NILM-automation/PCB_ESP32_SSR/README.md

# PCB_ESP32_SSR
PCB for the connection between the ESP32-WROOM-32 and a Solid State Relay. The ESP send an activation signal to SSR.

In adition, there is a temperature sensor texas tmp275
