NILM-automation/PCB_ESP32_SSR/Lista_elementos_PCB.xlsx

Sheet: LISTA ELEMENTOS
LISTA ELEMENTOS PCB NILM-UIS |  |  |  | LISTA ELEMENTOS PEDIDO DIGIKEY
CANTIDAD | DESCRIPCIÓN | PACKAGE | STOCK | CANTIDAD | DESCRIPCIÓN | PACKAGE | PRECIO
1 | LM1117 - 3,3 V | SOT-223 | SI | 2 | CAPACITOR 100 uF | X-0805 | $1.52
1 | CAPACITOR 100 uF | X-0805 | NO | 4 | PULSADOR | SMD | $2.80
1 | ESP32S | 32-S | SI | 10 | RESISTENCIA 10K | X-0805 | $0.48
4 | CAPACITOR 0,1 uF | X-0805 | SI | 2 | LED GREEN | X-0805 | $0.52
1 | CAPACITOR 4,7 uF | X-0805 | SI | 2 | LED RED | X-0805 | $0.52
2 | PULSADOR | SMD | NO | 10 | RESISTENCIA 12K | X-0805 | $0.49
5 | RESISTENCIA 10K | X-0805 | NO | 10 | RESISTENCIA 4,7K | X-0805 | $0.40
2 | CAPACITOR 1 uF | X-0805 | SI | 2 | TPD2S017 | SOT-95 | $1.22
2 | TRANSISTOR NPN S8050 | SOT-23 | NO | 4 | SP0503 | SOT-143 | $3.20
2 | LED | X-0805 | NO | 2 | PUERTO MICRO USB B 2,0 | SMD | $0.86
2 | RESISTENCIA 12K | X-0805 | NO | 10 | JUMPERS CON SUJETADOR |  | $1.74
1 | CP2102 | GM-QFN28 | SI | 3 | INA157U/2K5 | 8-SOIC | $11.37
1 | RESISTENCIA 4,7K | X-0805 | NO | 2 | SENSOR TEMPERATURA TMP275AIDR | 8-SOIC | $6.70
1 | TPD2S017 | SOT-95 | NO | 10 | CAPACITOR 0.01UF | X-0805 | $0.78
1 | SP0503 | SOT-143 | NO | 10 | RESISTENCIA 5K | X-0805 | $1.29
1 | PUERTO MICRO USB B 2,0 | SMD | NO | 10 | TRANSISTOR NPN S8050 | SOT-23 | $1.68
50 | REGLETA DE PINES | INSERCION | NO | 2 | RESISTENCIA 1M | X-0805 | $0.72
2 | CAPACITOR 10 uF | X-0805 | SI |  |  | TOTAL | $36.29
1 | BORNER DE 2 PUESTOS | INSERCION | NO |  | ENVIO USA - CASILLERO |  | $8.99
5 | JUMPERS CON SUJETADOR |  | NO |  | TAXES |  | $3.70
1 | INA157U/2K5 | SOIC-8 | NO |  | ENVIO CASILLERO - COL |  | $16.00
1 | SENSOR TEMPERATURA TMP275AIDR | SOIC-8 | NO |  |  | GRAN TOTAL USD | $64.98
3 | RESISTECNIAS 5K | X-0805 | NO |  |  | GRAN TOTAL COP | $259920.00
2 | CAPACIOTR 0.01UF | X-0805 | NO | DÓLAR
1 | RESISTENCIA 1M | X-0805 | NO | $4000.00

Sheet: COTIZACION_DIGIKEY
COTIZACIÓN ELEMENTOS PROJECT NILM-UIS EN DIGIKEY
CANTIDAD | DESCRIPCIÓN | PACKAGE | PART NUMBER | P / UNIDAD | P / TOTAL | LINK
1 | ESP32-WROOM-32 | SMD | 1904-1010-1-ND | 3.8 | 3.8 | https://www.digikey.com/product-detail/en/espressif-systems/ESP32-WROOM-32/1904-1010-1-ND/8544305
1 | REG 3.3V - LM1117 | SOT-223 | LM1117MPX-3.3/NOPBCT-ND | 1.1 | 1.1 | https://www.digikey.com/product-detail/en/texas-instruments/LM1117MPX-3-3-NOPB/LM1117MPX-3-3-NOPBCT-ND/1010516
2 | SWITCH TACTILE B3U-1000P | SMD | SW1020CT-ND | 0.98 | 1.96 | https://www.digikey.com/product-detail/en/omron-electronics-inc-emc-div/B3U-1000P/SW1020CT-ND/1534357
1 | SENSOR TEMP - TMP275AIDR | 8 - SOIC | 296-39296-1-ND | 3.35 | 3.35 | https://www.digikey.com/product-detail/en/TMP275AIDR/296-39296-1-ND/5143286/?itemSeq=319271916
1 | INA821ID | 8 - SOIC | 296-53404-ND | 6.19 | 6.19 | https://www.digikey.com/product-detail/en/texas-instruments/INA821ID/296-53404-ND/9858339
1 | CP2102-GM | QFN - 28 | 336-5890-1-ND | 1.4 | 1.4 | https://www.digikey.com/product-detail/en/silicon-labs/CP2102N-A02-GQFN28R/336-5890-1-ND/9863483
1 | TPD2S017DBVR | SOT - 23 | 296-25216-1-ND | 0.61 | 0.61 | https://www.digikey.com/product-detail/en/TPD2S017DBVR/296-25216-1-ND/2172703/?itemSeq=317171693
2 | TRANS NPN - MMSS8050-L-TP | SOT - 23 | MMSS8050-L-TPMSCT-ND | 0.18 | 0.36 | https://www.digikey.com/product-detail/en/MMSS8050-L-TP/MMSS8050-L-TPMSCT-ND/2827203/?itemSeq=324663815
1 | MICRO USB B - 10118192-001LF | SMD | 609-4613-1-ND | 0.43 | 0.43 | https://www.digikey.com/product-detail/en/10118192-0001LF/609-4613-1-ND/2785378/?itemSeq=317169616
1 | LED GREEN | SMD - 0805 | 475-1410-1-ND | 0.26 | 0.26 | https://www.digikey.com/product-detail/en/LG+R971-KN-1/475-1410-1-ND/1802598/?itemSeq=317171616
1 | LED RED | SMD - 0805 | 475-1415-1-ND | 0.26 | 0.26 | https://www.digikey.com/product-detail/en/LH+R974-LP-1/475-1415-1-ND/1802604/?itemSeq=317171622
1 | CAPACITOR 100 UF | SMD - 0805 | 490-13982-1-ND | 0.76 | 0.76 | https://www.digikey.com/product-detail/en/GRM31CR60J107KE39L/490-13982-1-ND/6155812/?itemSeq=317169822
6 | CAPACITOR 0.1 UF | SMD - 0805 | 399-1171-1-ND | 0.19 | 1.14 | https://www.digikey.com/product-detail/en/kemet/C0805C104J5RACTU/399-1171-1-ND/411446
2 | CAPACITOR 0.01 UF | SMD - 0805 | 399-17616-1-ND | 0.11 | 0.22 | https://www.digikey.com/product-detail/en/C0805C103J5RAC7210/399-17616-1-ND/8572616/?itemSeq=325112023
2 | CAPACITOR 1 UF | SMD - 0805 | 311-3498-1-ND | 0.33 | 0.66 | https://www.digikey.com/product-detail/en/yageo/CC0805JKX7R9BB105/311-3498-1-ND/7164519
1 | CAPACITOR 4.7 UF | SMD - 0805 | 399-15708-1-ND | 0.61 | 0.61 | https://www.digikey.com/product-detail/en/kemet/C0805C475J8RACAUTO/399-15708-1-ND/7427588
2 | CAPACITOR 10 UF | SMD - 0805 | 399-15693-1-ND | 0.83 | 1.66 | https://www.digikey.com/product-detail/en/kemet/C0805C106J8RACAUTO/399-15693-1-ND/7427573
5 | RESISTENCIA 10K | SMD - 0805 | A129761CT-ND | 0.1 | 0.5 | https://www.digikey.com/product-detail/en/CRGCQ0805F10K/A129761CT-ND/8577593/?itemSeq=317170571
3 | RESISTENCIA 5K | SMD - 0805 | 541-4321-1-ND | 0.14 | 0.42 | https://www.digikey.com/product-detail/en/CRCW08055K00FKTA/541-4321-1-ND/8565934/?itemSeq=319272543
2 | RESISTENCIA 12K | SMD - 0805 | A126337CT-ND | 0.1 | 0.2 | https://www.digikey.com/product-detail/en/CRG0805F12K/A126337CT-ND/7603392/?itemSeq=317170622
1 | RESISTENCIA 1M | SMD - 0805 | P20936CT-ND | 0.36 | 0.36 | https://www.digikey.com/product-detail/en/ERJ-PB6B1004V/P20936CT-ND/6215191/?itemSeq=325112308
1 | RESISTENCIA 25K (24,7K) | SMD - 0805 | A121556CT-ND | 0.65 | 0.65 | https://www.digikey.com/product-detail/en/te-connectivity-passive-product/CPF0805B25KE1/A121556CT-ND/5246518
2 | BORNERAS 2 POSICIONES | THROUGH HOLE | 277-6405-ND | 0.49 | 0.98 | https://www.digikey.com/product-detail/en/phoenix-contact/1935776/277-6405-ND/2513905
1 | BORNERAS 3 POSICIONES | THROUGH HOLE | 277-6072-ND | 0.77 | 0.77 | https://www.digikey.com/product-detail/en/phoenix-contact/1935789/277-6072-ND/2513906
2 | PIN HEADER X2 POSICIONES | THROUGH HOLE | 732-5315-ND | 0.13 | 0.26 | https://www.digikey.com/product-detail/en/w%C3%BCrth-elektronik/61300211121/732-5315-ND/4846823
1 | JUMPER CONECTOR | BULK | S9337-ND | 0.1 | 0.1 | https://www.digikey.com/product-detail/en/sullins-connector-solutions/QPC02SXGN-RC/S9337-ND/2618262
4 | PIN HEADER X9 POSICIONES | THROUGH HOLE | 732-5322-ND | 0.41 | 1.64 | https://www.digikey.com/product-detail/en/w%C3%BCrth-elektronik/61300911121/732-5322-ND/4846843
1 | PIN HEADER X1 POSICIONES | THROUGH HOLE | 609-3466-ND | 0.11 | 0.11 | https://www.digikey.com/product-detail/en/amphenol-icc-fci/68000-401HLF/609-3466-ND/2023286
 |  |  |  | TOTAL | 30.76
 |  |  |  | ENVIO USA | 18
 |  | DIVISA DÓLAR |  | ENVIO USA-COL | 16
 |  | 3800 |  | TOTAL (USD) | 64.76
 |  |  |  | TOTAL (COP) | 246088
