NILM-automation/PCB_ESP32_SSR/Libraries_EAGLE/2020-04-28_17-01-08/STL/D8_TEX.stp

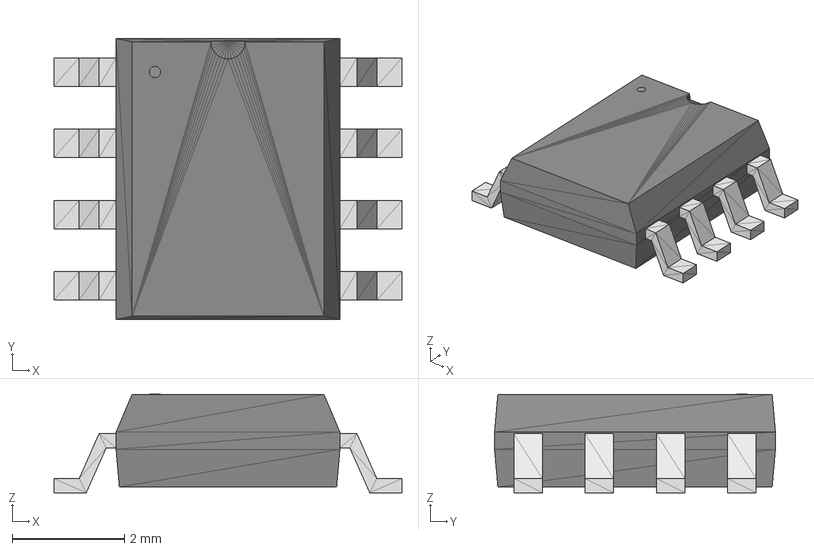
[picture p2: CAD file, 2020-05-02]
Libraries_EAGLE/2020-04-28_17-01-08/STL/D8_TEX.stp
6.20 x 5.00 x 1.75 mm
