NILM-automation/PCB_ESP32_SSR/Libraries_EAGLE/STEP/D0008A.stp

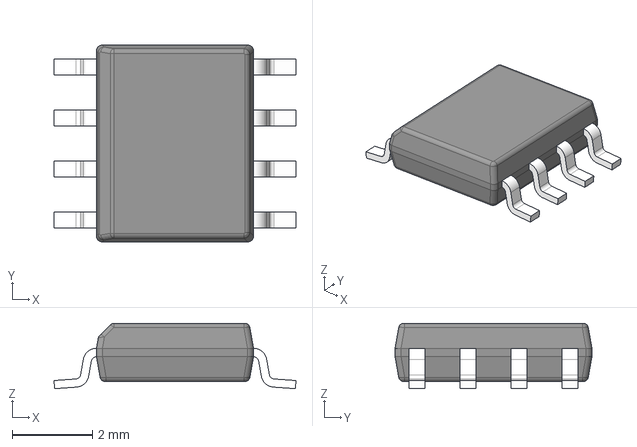
[picture p3: CAD file, 2020-05-11]
Libraries_EAGLE/STEP/D0008A.stp
6.02 x 4.90 x 1.63 mm
BODY-SO
LEAD-D0008A x 8
