NILM-automation/PCB_ESP32_SSR/(list of files, cad)

Other CAD files:
Libraries_EAGLE/2020-04-28_17-01-04/STEP/D8_TEX-L.step
Libraries_EAGLE/2020-04-28_17-01-08/STL/D8_TEX-L.stp
Libraries_EAGLE/2020-04-28_17-01-04/STEP/D8_TEX.step
Libraries_EAGLE/2020-04-28_17-01-08/STL/D8_TEX-M.stp
Libraries_EAGLE/2020-04-28_17-01-08/STL/D8_TEX-L.stl
Libraries_EAGLE/2020-04-28_17-01-08/STL/D8_TEX-M.stl
Libraries_EAGLE/2020-04-28_17-01-08/STL/D8_TEX.stl
