NILM-automation/PCB_ESP32_SSR/Simulaciones/NILM_PROJECT_TEST2-PSpiceFiles/SCHEMATIC1/test_2/test_2.cir

** Profile: "SCHEMATIC1-test_2"  [ e:\pcb_esp_usb\simulaciones\nilm_project_test2-pspicefiles\schematic1\test_2.sim ] 

** Creating circuit file "test_2.cir" 
** WARNING: THIS AUTOMATICALLY GENERATED FILE MAY BE OVERWRITTEN BY SUBSEQUENT SIMULATIONS

*Libraries: 
* Profile Libraries :
* Local Libraries :
.LIB "F:/Cadence/SPB_17.2/tools/pspice/library/INA821.lib" 
* From [PSPICE NETLIST] section of F:\SPB_Data\cdssetup\OrCAD_PSpice\17.2.0\PSpice.ini file:
.lib "nom.lib" 

*Analysis directives: 
.TRAN  0 3 0 0.001 
.OPTIONS ADVCONV
.PROBE64 V(alias(*)) I(alias(*)) W(alias(*)) D(alias(*)) NOISE(alias(*)) 
.INC "..\SCHEMATIC1.net" 


.END
