NILM-automation/PCB_ESP32_SSR/Libraries_Pspice/INA821_PSpice/INA821 Test Circuit-PSpiceFiles/SCHEMATIC1/INA821 Test Circuit/INA821 Test Circuit.cir

** Profile: "SCHEMATIC1-INA821 Test Circuit"  [ C:\Macromodels\Models\INA821\Release\RTM\INA821_PSpice\ina821 test circuit-pspicefiles\schematic1\ina821 test circuit.sim ] 

** Creating circuit file "INA821 Test Circuit.cir" 
** WARNING: THIS AUTOMATICALLY GENERATED FILE MAY BE OVERWRITTEN BY SUBSEQUENT SIMULATIONS

*Libraries: 
* Profile Libraries :
* Local Libraries :
.LIB "../../../ina821.lib" 
* From [PSPICE NETLIST] section of C:\Users\a0282827\AppData\Roaming\SPB_Data\cdssetup\OrCAD_PSpice/16.6.0/PSpice.ini file:
.lib "nom.lib" 

*Analysis directives: 
.TRAN  0 2m 0 2u 
.OPTIONS ADVCONV
.OPTIONS METHOD= Default
.AUTOCONVERGE ITL1=1000 ITL2=1000 ITL4=1000 RELTOL=0.05 ABSTOL=1.0E-6 VNTOL=.001 PIVTOL=1.0E-10 
.PROBE64 V(alias(*)) I(alias(*)) W(alias(*)) D(alias(*)) NOISE(alias(*)) 
.INC "..\SCHEMATIC1.net" 


.END
