NILM-automation/PCB_ESP32_SSR/(list of files, drawings)

Other design files:
Libraries_Pspice/INA157_PSPICE_AIO/INA157.DSN
Libraries_Pspice/INA157_PSPICE_AIO/INA157.OLB
Libraries_Pspice/INA157_PSPICE_AIO/INA157.opj
Libraries_Pspice/INA821_PSpice/INA821 TEST CIRCUIT.DSN
Libraries_Pspice/INA821_PSpice/INA821 Test Circuit.opj
Libraries_Pspice/INA821_PSpice/INA821.OLB
Simulaciones/NILM_PROJECT_TEST1.DSN
Simulaciones/NILM_PROJECT_TEST1.opj
Simulaciones/NILM_PROJECT_TEST2.DSN
Simulaciones/NILM_PROJECT_TEST2.opj
