NILM-automation/PCB_ESP32_SSR/Schematic_Board/esq_ordenado.brd

## EAGLE design Schematic_Board/esq_ordenado.brd (2020-06-04)

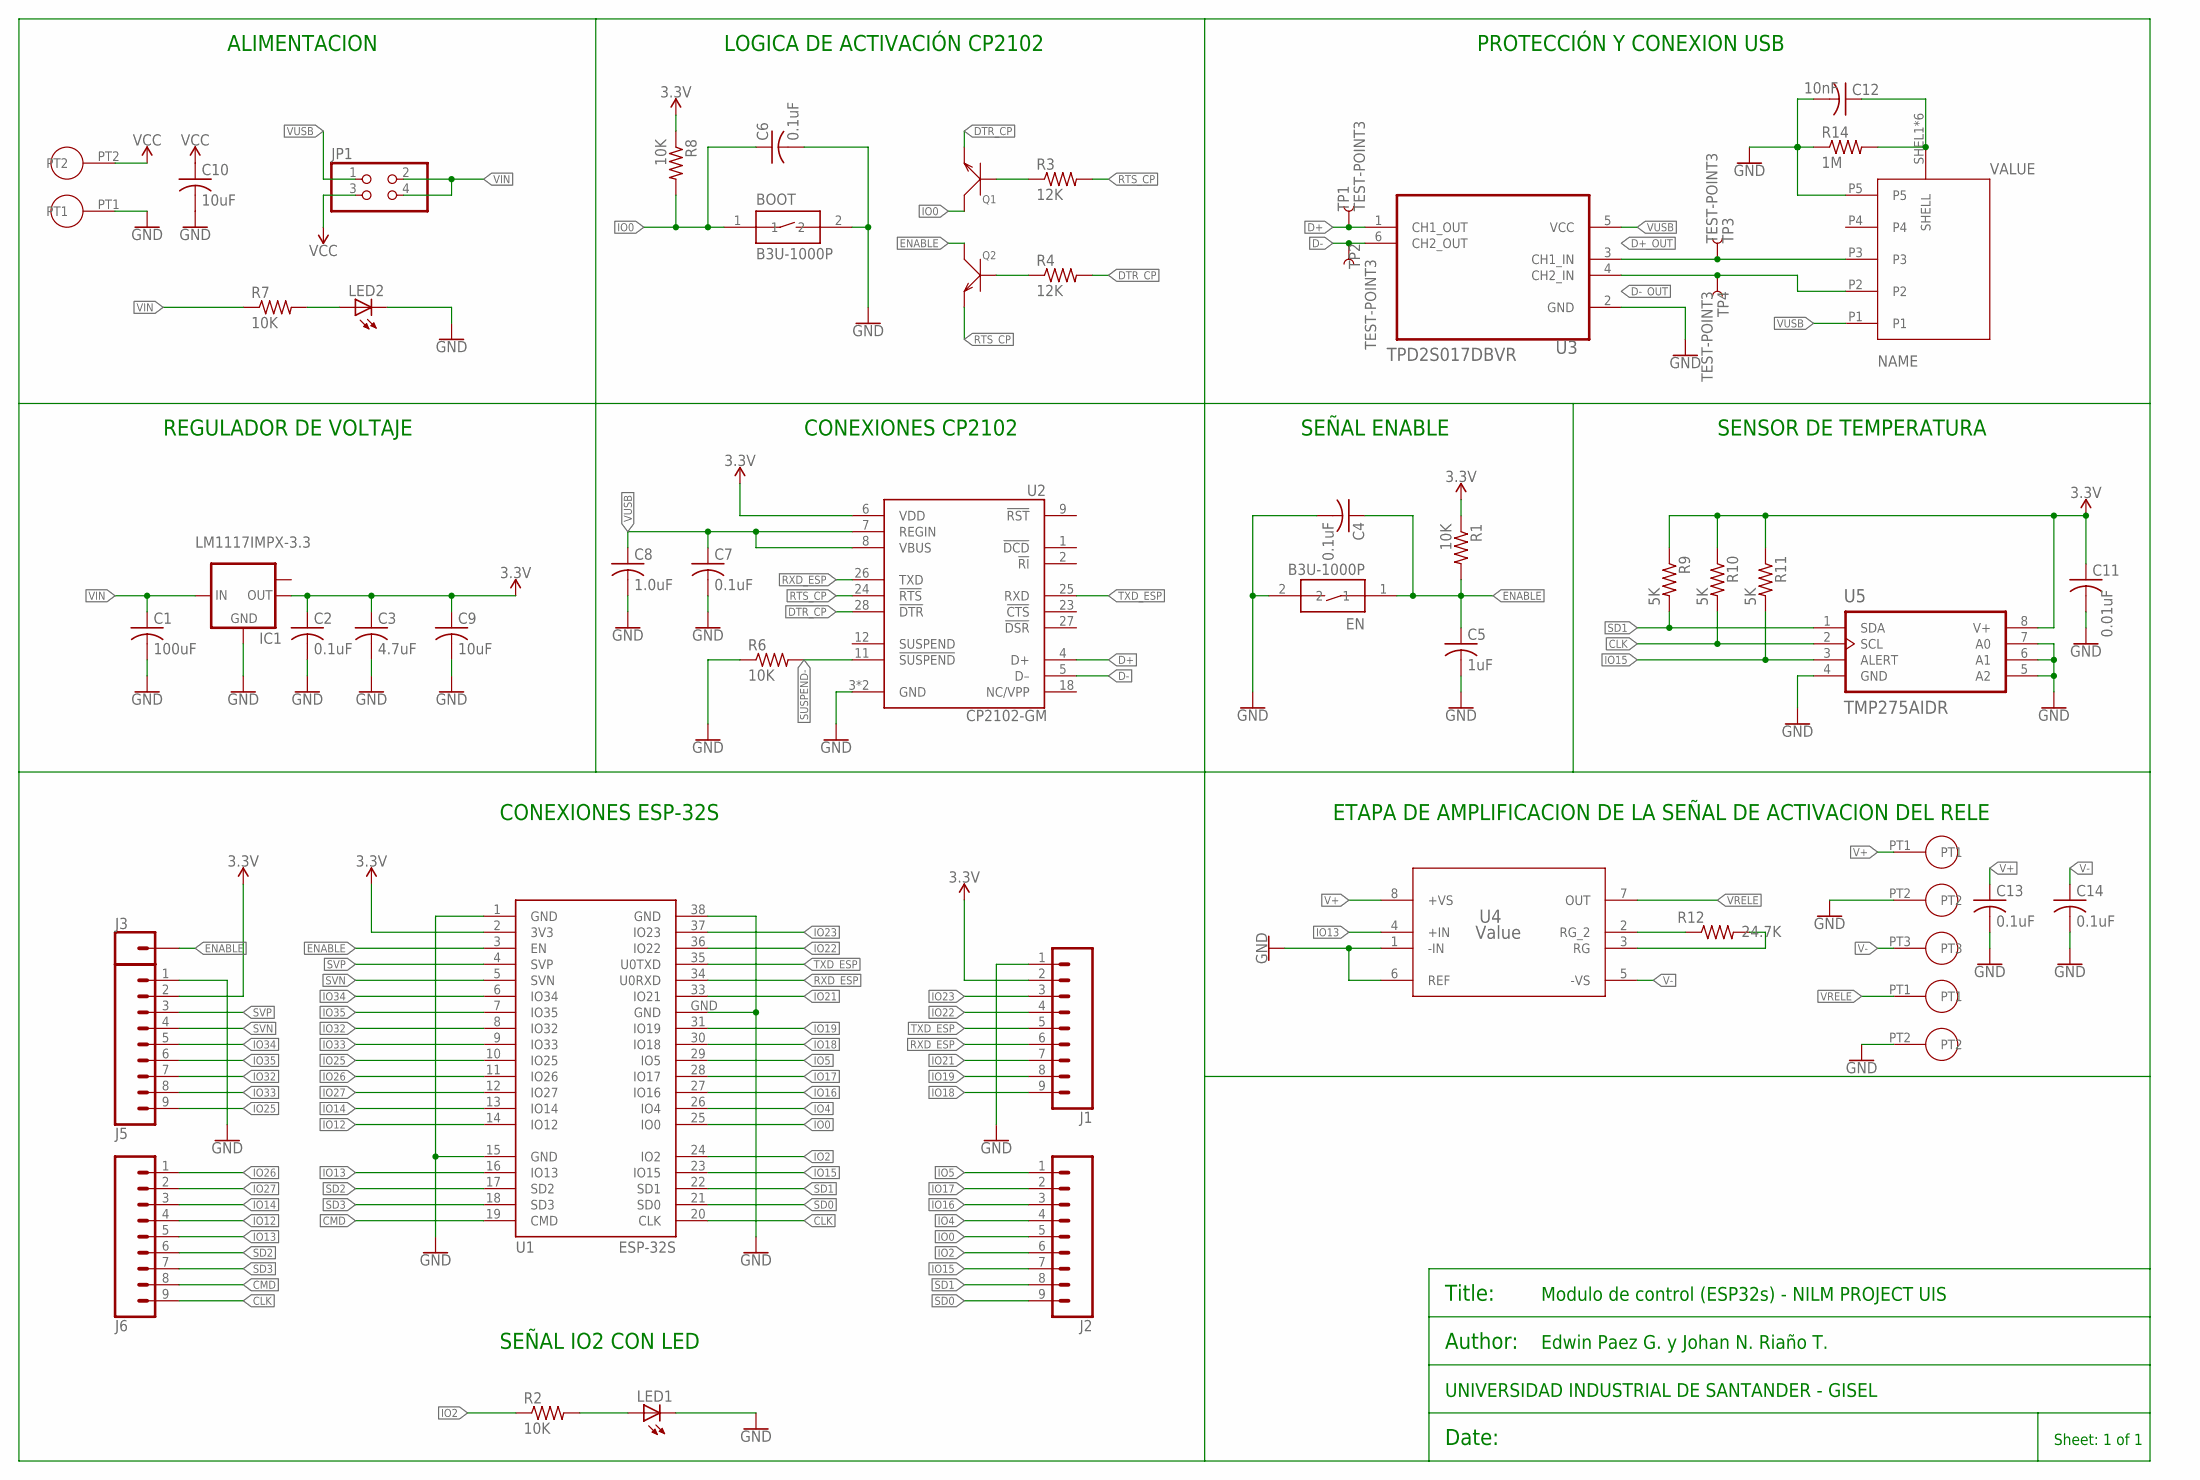
[picture p4: schematic esq_ordenado.sch]

Parts:
BOOT: B3U-1000P
C1: 100uF; C0805
C2, C4, C6, C7, C13, C14: 0.1uF; C0805
C3: 4.7uF; C0805
C5: 1uF; C0805
C8: 1.0uF; C0805
C9, C10: 10uF; C0805
C11: 0.01uF; C0805
C12: 10nF; C0805
EN: B3U-1000P
IC1: LM1117IMPX-3.3; SOT223
J1, J2, J5, J6: CONN_09; 1X09
J3: CONN_01; 1X01
JP1: PINHD-2X2; 2X02
LED1, LED2: LEDCHIPLED_0805; CHIPLED_0805
Q1, Q2: SMD-TRANSISTORS-NPN-25V-500MW(SOT-23); SOT-23
R1, R2, R6, R7, R8: 10K; R0805
R3, R4: 12K; R0805
R9, R10, R11: 5K; R0805
R12: 24.7K; R0805
R14: 1M; R0805
TP1, TP2, TP3, TP4: TEST-POINT3; PAD.03X.03
U1: ESP-32S
U2: CP2102-GM; QFN50P500X500X100-29N
U3: TPD2S017DBVR; SOT95P280X145-6N
U4: Value; D0008A_M
U5: TMP275AIDR
U$1: MICRO_USB_B-AMPHENOL(10118192); MICRO_B_10118192
U$2, U$3: PT2,5/2-5,0
U$4: PT2,5/3-5,0

Connections:
3.3V: C2.1, C3.1, C9.1, C11.1, IC1.2 (OUT), J1.2, J5.2, R1.1, R8.1, R9.1, R10.1, R11.1, U1.2 (3V3), U2.6 (VDD), U5.8 (V+)
CLK: J6.9, R10.2, U1.20 (CLK), U5.2 (SCL)
CMD: J6.8, U1.19 (CMD)
D+: TP1.P$1, U2.4 (D+), U3.1 (CH1_OUT)
D+_OUT: TP3.P$1, U3.3 (CH1_IN), U$1.P3
D-: TP2.P$1, U2.5 (D–), U3.6 (CH2_OUT)
D-_OUT: TP4.P$1, U3.4 (CH2_IN), U$1.P2
DTR_CP: Q1.2 (E), R4.2, U2.28 (!DTR)
ENABLE: C4.1, C5.1, EN.1, J3.1, Q2.3 (C), R1.2, U1.3 (EN)
GND: BOOT.2, C1.2, C2.2, C3.2, C4.2, C5.2, C6.2, C7.2, C8.2, C9.2, C10.2, C11.2, C12.2, C13.2, C14.2, EN.2, IC1.1 (GND), J1.1, J5.1, LED1.C, LED2.C, R6.1, R14.1, U1.1 (GND), U1.15 (GND), U1.38 (GND), U1.GND, U2.3 (GND), U2.29 (GND), U3.2 (GND), U4.1 (-IN), U4.6 (REF), U5.4 (GND), U5.5 (A2), U5.6 (A1), U5.7 (A0), U$1.P5, U$2.PT1, U$3.PT2, U$4.PT2
IO0: BOOT.1, C6.1, J2.5, Q1.3 (C), R8.2, U1.25 (IO0)
IO2: J2.6, R2.1, U1.24 (IO2)
IO4: J2.4, U1.26 (IO4)
IO5: J2.1, U1.29 (IO5)
IO12: J6.4, U1.14 (IO12)
IO13: J6.5, U1.16 (IO13), U4.4 (+IN)
IO14: J6.3, U1.13 (IO14)
IO15: J2.7, R11.2, U1.23 (IO15), U5.3 (ALERT)
IO16: J2.3, U1.27 (IO16)
IO17: J2.2, U1.28 (IO17)
IO18: J1.9, U1.30 (IO18)
IO19: J1.8, U1.31 (IO19)
IO21: J1.7, U1.33 (IO21)
IO22: J1.4, U1.36 (IO22)
IO23: J1.3, U1.37 (IO23)
IO25: J5.9, U1.10 (IO25)
IO26: J6.1, U1.11 (IO26)
IO27: J6.2, U1.12 (IO27)
IO32: J5.7, U1.8 (IO32)
IO33: J5.8, U1.9 (IO33)
IO34: J5.5, U1.6 (IO34)
IO35: J5.6, U1.7 (IO35)
unnamed: LED1.A, R2.2
unnamed: Q1.1 (B), R3.1
unnamed: Q2.1 (B), R4.1
unnamed: LED2.A, R7.2
unnamed: C12.1, R14.2, U$1.SHEL1 (SHELL), U$1.SHEL2 (SHELL), U$1.SHEL3 (SHELL), U$1.SHEL4 (SHELL), U$1.SHEL5 (SHELL), U$1.SHEL6 (SHELL)
unnamed: R12.1, U4.2 (RG_2)
unnamed: R12.2, U4.3 (RG)
RTS_CP: Q2.2 (E), R3.2, U2.24 (!RTS)
RXD_ESP: J1.6, U1.34 (U0RXD), U2.26 (TXD)
SD0: J2.9, U1.21 (SD0)
SD1: J2.8, R9.2, U1.22 (SD1), U5.1 (SDA)
SD2: J6.6, U1.17 (SD2)
SD3: J6.7, U1.18 (SD3)
SUSPEND-: R6.2, U2.11 (!SUSPEND)
SVN: J5.4, U1.5 (SVN)
SVP: J5.3, U1.4 (SVP)
TXD_ESP: J1.5, U1.35 (U0TXD), U2.25 (RXD)
V+: C13.1, U4.8 (+VS), U$4.PT1
V-: C14.1, U4.5 (-VS), U$4.PT3
VCC: C10.1, JP1.3, U$2.PT2
VIN: C1.1, IC1.3 (IN), JP1.2, JP1.4, R7.1
VRELE: U4.7 (OUT), U$3.PT1
VUSB: C7.1, C8.1, JP1.1, U2.7 (REGIN), U2.8 (VBUS), U3.5 (VCC), U$1.P1

Notes on the sheet:
REGULADOR DE VOLTAJE
SEÑAL ENABLE
CONEXIONES ESP-32S
SEÑAL IO2 CON LED
LOGICA DE ACTIVACIÓN CP2102
CONEXIONES CP2102
PROTECCIÓN Y CONEXION USB
ALIMENTACION
SENSOR DE TEMPERATURA
ETAPA DE AMPLIFICACION DE LA SEÑAL DE ACTIVACION DEL RELE
Modulo de control (ESP32s) - NILM PROJECT UIS
Title:
Author:
Edwin Paez G. y Johan N. Riaño T.
UNIVERSIDAD INDUSTRIAL DE SANTANDER - GISEL
Sheet: 1 of 1
Date:

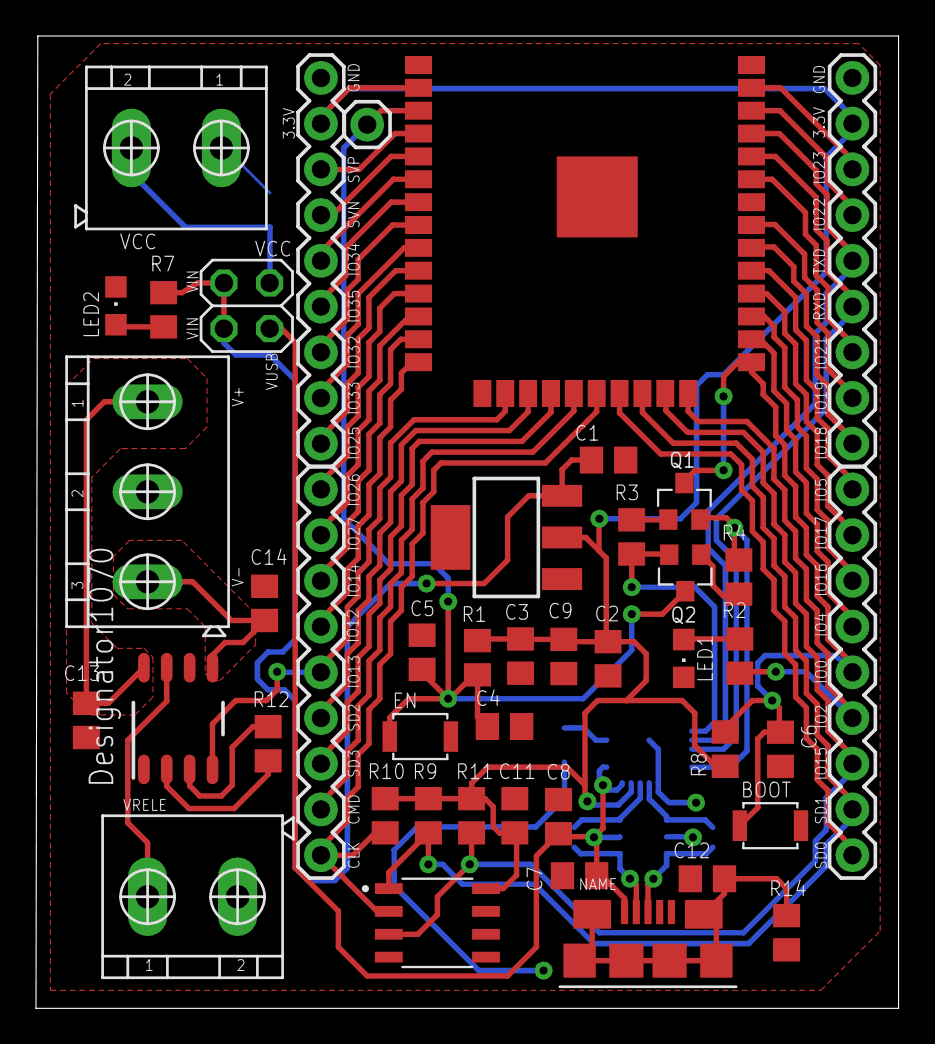
[picture p5: board esq_ordenado.brd from above]

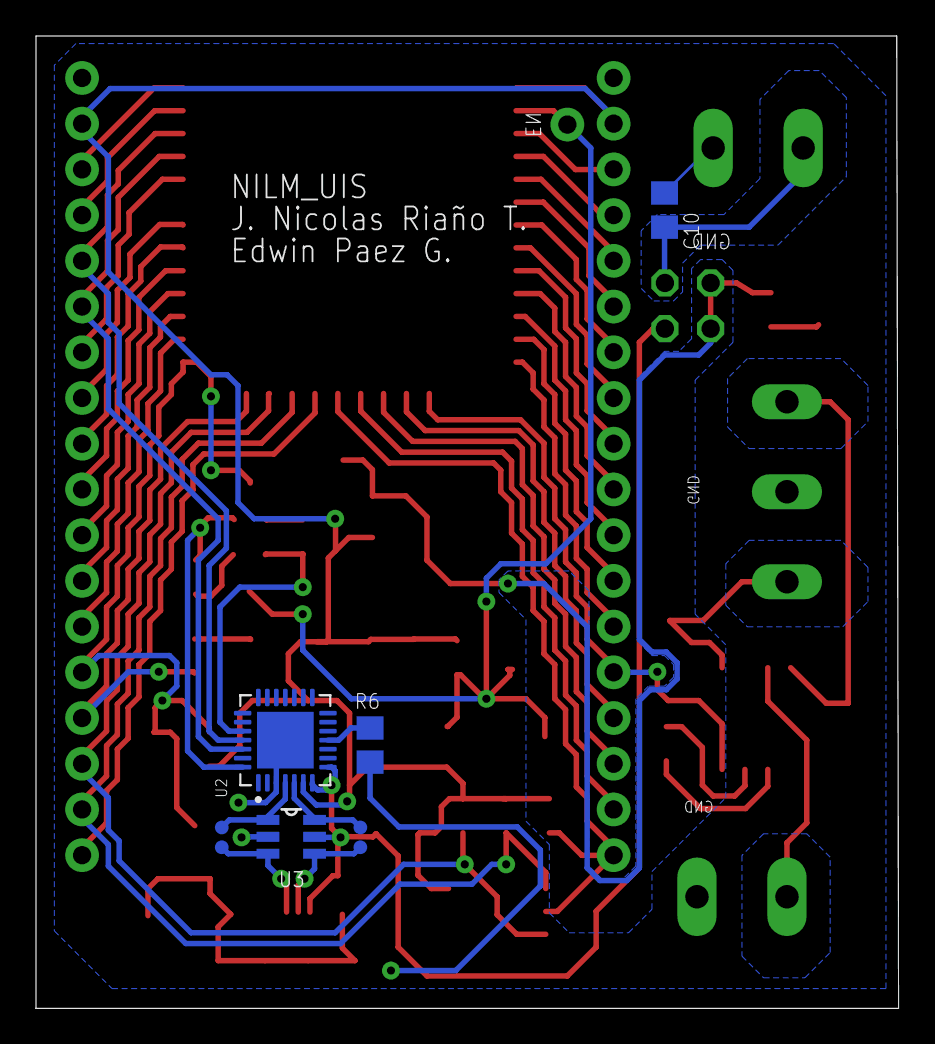
[picture p6: board esq_ordenado.brd from below]

Board: 2 copper layers, 47.9 x 54.0 mm, 52 parts (8 on the bottom side), 55 nets.
