NILM-automation/PCB_ESP32_SSR/Libraries_EAGLE/ESP-WROOM-32-Eagle-Breakout-master/ESP-WROOM-32-Breakout.brd

## EAGLE design Libraries_EAGLE/ESP-WROOM-32-Eagle-Breakout-master/ESP-WROOM-32-Breakout.brd (2019-12-14)

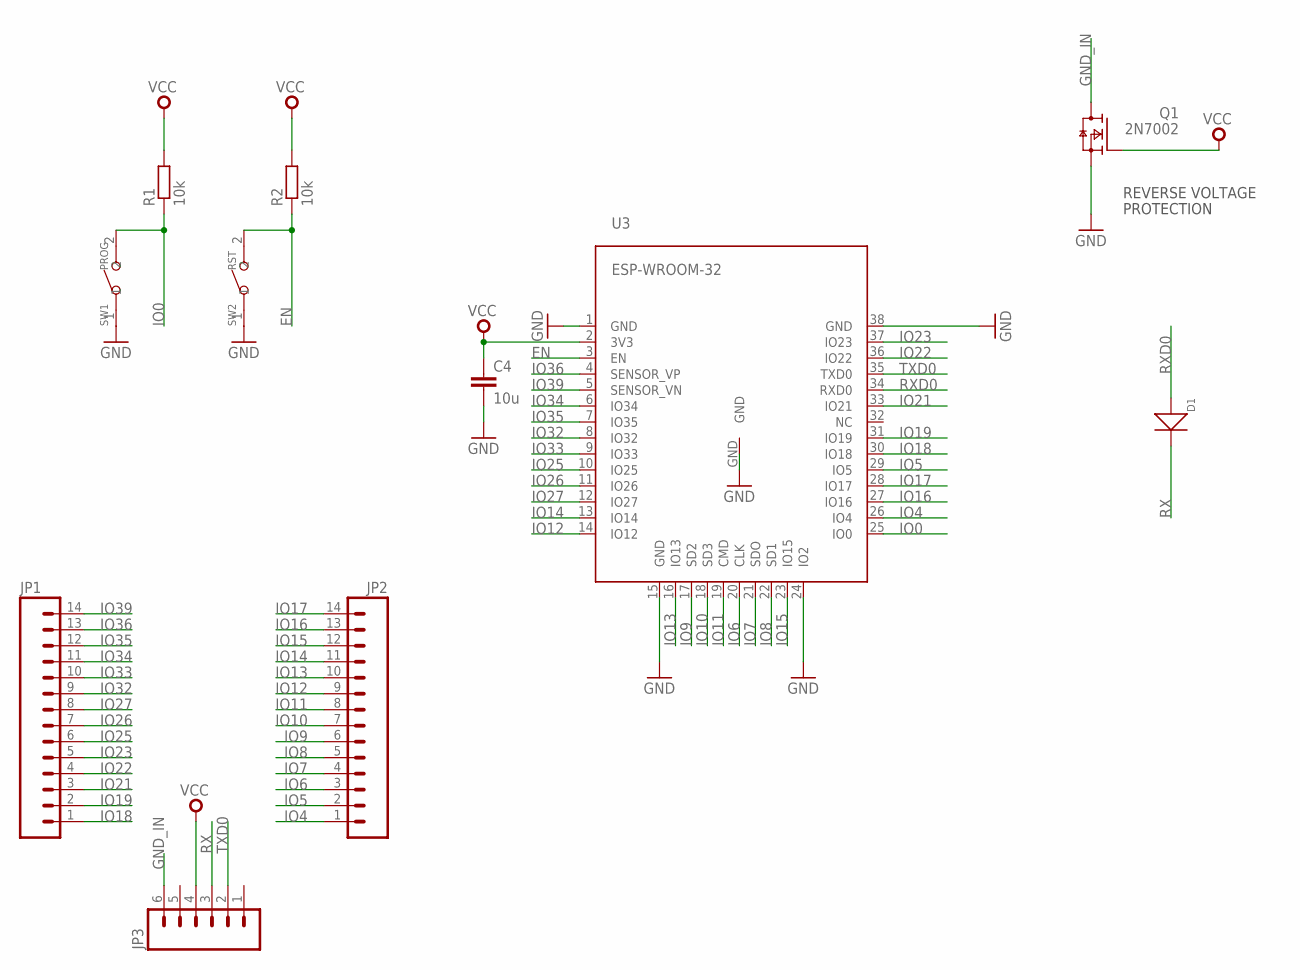
[picture p7: schematic ESP-WROOM-32-Breakout.sch]

Parts:
C4: 10u; C0603
D1: DIODE'0805'; SOD-323
JP1, JP2: M14; 1X14
JP3: M06SILK_FEMALE_PTH; 1X06
Q1: 2N7002; SOT23
R1, R2: 10k; R0603
SW1: PROG; SW2-4.0-6.0X3.0X2.5MM
SW2: RST; SW2-4.0-6.0X3.0X2.5MM
U3: ESP-WROOM-32

Connections:
EN: R2.1, SW2.2, U3.3 (EN)
GND: C4.2, Q1.2 (S), SW1.1, SW2.1, U3.1 (GND), U3.15 (GND), U3.24 (IO2), U3.38 (GND), U3.GND
GND_IN: JP3.6, Q1.3 (D)
IO0: R1.1, SW1.2, U3.25 (IO0)
IO4: JP2.1, U3.26 (IO4)
IO5: JP2.2, U3.29 (IO5)
IO6: JP2.3, U3.20 (CLK)
IO7: JP2.4, U3.21 (SDO)
IO8: JP2.5, U3.22 (SD1)
IO9: JP2.6, U3.17 (SD2)
IO10: JP2.7, U3.18 (SD3)
IO11: JP2.8, U3.19 (CMD)
IO12: JP2.9, U3.14 (IO12)
IO13: JP2.10, U3.16 (IO13)
IO14: JP2.11, U3.13 (IO14)
IO15: JP2.12, U3.23 (IO15)
IO16: JP2.13, U3.27 (IO16)
IO17: JP2.14, U3.28 (IO17)
IO18: JP1.1, U3.30 (IO18)
IO19: JP1.2, U3.31 (IO19)
IO21: JP1.3, U3.33 (IO21)
IO22: JP1.4, U3.36 (IO22)
IO23: JP1.5, U3.37 (IO23)
IO25: JP1.6, U3.10 (IO25)
IO26: JP1.7, U3.11 (IO26)
IO27: JP1.8, U3.12 (IO27)
IO32: JP1.9, U3.8 (IO32)
IO33: JP1.10, U3.9 (IO33)
IO34: JP1.11, U3.6 (IO34)
IO35: JP1.12, U3.7 (IO35)
IO36: JP1.13, U3.4 (SENSOR_VP)
IO39: JP1.14, U3.5 (SENSOR_VN)
RX: D1.-, JP3.3
RXD0: D1.+, U3.34 (RXD0)
TXD0: JP3.2, U3.35 (TXD0)
VCC: C4.1, JP3.4, Q1.1 (G), R1.2, R2.2, U3.2 (3V3)

Notes on the sheet:
REVERSE VOLTAGE
PROTECTION

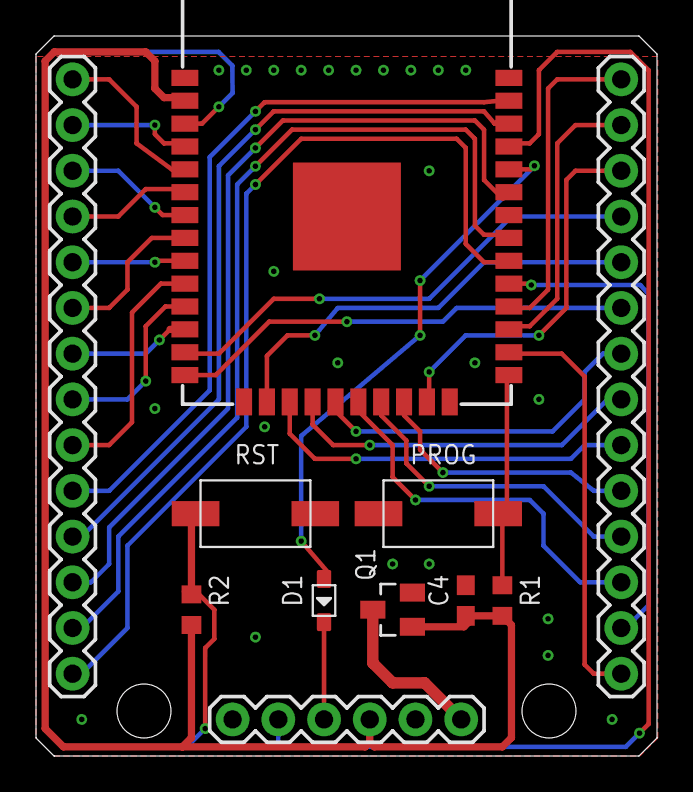
[picture p8: board ESP-WROOM-32-Breakout.brd from above]

Board: 2 copper layers, 34.5 x 40.0 mm, 11 parts (0 on the bottom side), 36 nets.
