NILM-automation/PCB_ESP32_SSR/(commit log)

2019-12-14 incluyendo directorios y primer avance de la PCB
    [esq_ordenado.brd, esq_ordenado.sch]
2019-12-16 Adicionando Datasheet TPD2S017 y conexiones entre D+ y D- a la regleta
    [esq_ordenado.brd, esq_ordenado.sch]
2019-12-17 Correcciones D+ Y D- en TPD2S017 y en los pines, para un mejor ruteo
    [esq_ordenado.brd, esq_ordenado.sch]
2019-12-18 PCB terminada cumpliendo la mayoria de normas
    [esq_ordenado.brd]
2020-04-22 pcb segunda version terminada
    [DRILEGEND.CFG, Lista_elementos_PCB.xlsx, esq_ordenado.brd, esq_ordenado.sch]
2020-05-02 actualizacion de datahseets, lista de elementos, esquematico terminado
    [Lista_elementos_PCB.xlsx, esq_ordenado.brd, esq_ordenado.sch]
2020-05-05 corrección footprint switch tactile y borrado de pistas de la board
    [esq_ordenado.brd, esq_ordenado.sch]
2020-05-11 actualizacion de files/Schematic/Board/Datasheet..
    [D0008A.stp, D8_TEX-L.step, D8_TEX-L.stl, D8_TEX-L.stp, D8_TEX-M.step, D8_TEX-M.stl, D8_TEX-M.stp, D8_TEX.step]
2020-05-19 Nuevos switch, option1 D+ D-
    [esq_ordenado.brd, esq_ordenado.sch]
2020-05-26 Version final-revision nicolas
    [esq_ordenado.brd, esq_ordenado.sch]
2020-05-29 Correc Borneras - revision nicolas
    [Lista_elementos_PCB.xlsx, esq_ordenado.brd, esq_ordenado.sch]
2020-05-31 centrar PCB - revision nicolas
    [esq_ordenado.brd]
2020-05-31 Lista elementos terminada - revision nicolas
    [Lista_elementos_PCB.xlsx]
2020-06-04 DRC Y ERC CHECK - revision nicolas
    [NILM_PROJECT_TEST2.DSN, NILM_PROJECT_TEST2.opj, esq_ordenado.brd, esq_ordenado.sch]
