NILM-automation/PCB_ESP32_SSR/(notices)

Notices in the files:
parts and their libraries:
SparkFun-Aesthetics: Licensing: Creative Commons ShareAlike 4.0 International - https://creativecommons.org/licenses/by-sa/4.0
esp32: Creative Commons Attribution-ShareAlike 4.0 International
